wintermao/CycloneIV_DDR2/(list of files, cad)

Other CAD files:
ddr_layout_V5/test_dac2904_jit.stp
ddr_layout_V5/test_dac2904_jit_auto_stripped.stp
ddr_layout_V5/spi_da.stp
ddr_layout_V5/spi_da_auto_stripped.stp
ddr_layout_V5/spi_test.stp
ddr_layout_V5/spi_test_auto_stripped.stp
