wintermao/CycloneIV_DDR2/ddr_layout_V5/software/timestamp/test result.txt

//base_addr=0x4000000
system freq= 54000000 Hz
test data size=0x100000
byte mode: t0=232 t1=161813278 dt=161813046 time=2.996538s
word mode : t0=161920835 t1=243030699 dt=81109864 time=1.502035s
dword mode : t0=243136543 t1=283690981 dt=40554438 time=0.751008s
ddword mode : t0=283799846 t1=306557779 dt=22757933 time=0.421443s

//base_addr=0x000000
system freq= 54000000 Hz
test data size=0x100000
byte mode: t0=246 t1=161667552 dt=161667306 time=2.993839s
word mode : t0=161772758 t1=242826644 dt=81053886 time=1.500998s
dword mode : t0=242932235 t1=283452481 dt=40520246 time=0.750375s
ddword mode : t0=283560182 t1=306285879 dt=22725697 time=0.420846s
