wintermao/CycloneIV_DDR2/ddr_layout_V5/ip/triangle_demodu/hdl/triangle_define.v

`define ADDR_AMP_MAX				4'h0
`define ADDR_AMP_MIN				4'h1
`define ADDR_FREQ_DIV				4'h2
`define ADDR_POINT					4'h3
`define ADDR_SAMPLE1_START	4'h4
`define ADDR_SAMPLE2_START	4'h5
`define ADDR_SAMPLE1_NUM		4'h6
`define ADDR_SAMPLE2_NUM		4'h7
