wintermao/CycloneIV_DDR2/ddr_layout_V5/software/dma_epcs_to_dac/clk_device.h

/*
 * clk_device.h
 *
 *  Created on: 2018-4-14
 *      Author: mmh
 */

#ifndef CLK_DEVICE_H_
#define CLK_DEVICE_H_
#define AD1	0
#define AD2	1
#define DAC1 2
#define DAC2 3
#define DAC3 4
#define DAC4 5
#define LIGHT 6

#endif /* CLK_DEVICE_H_ */
