wintermao/CycloneIV_DDR2/ddr_layout_V5/ip/i2c_opencores/HAL/inc/i2c_opencores.h

#ifndef __I2C_OPENCORES_H__
#define __I2C_OPENCORES_H__


#include "alt_types.h"

#ifdef __cplusplus
extern "C"
{
#endif /* __cplusplus */




void I2C_init(alt_u32 base,alt_u32 clk,alt_u32 speed);
int I2C_start(alt_u32 base, alt_u32 add, alt_u32 read);
alt_u32 I2C_read(alt_u32 base,alt_u32 last);
alt_u32 I2C_write(alt_u32 base,alt_u8 data, alt_u32 last);
#define I2C_OK (0)
#define I2C_ACK (0)
#define I2C_NOACK (1)
#define I2C_ABITRATION_LOST (2)

#define I2C_OPENCORES_INSTANCE(name, dev) extern int alt_no_storage
#define I2C_OPENCORES_INIT(name, dev) while (0)

#ifdef __cplusplus
}
#endif /* __cplusplus */

#endif /* __I2C_OPENCORES_H__ */
