wintermao/CycloneIV_DDR2/ddr_layout_V5/ip/ad9245/hdl/ad9245.v

module ad9245					
(
	//ad9245 interface
	input  wire [13:0] ad_data,		//ad sample data
	
	//AVALON interface
	input  wire clk,							//AVALON clock
	input  wire reset_n,					//AVALON reset_n
	input  wire chipselect,				//AVALON chipselect
	input  wire read,							//AVALON read
	output reg [31:0] readdata		//AVALON read data
);

	always @(posedge clk or negedge reset_n)
	begin
		if (!reset_n)
		begin
			//system init
		end
		else
		begin
			if(chipselect && read)		//AVALON read 
			begin
				readdata <= {18'h0,ad_data};
			end
		end
	end

endmodule
