wintermao/CycloneIV_DDR2/ddr_layout_V5/ip/wave_gen/hdl/Cordic_Test.v

module Cordic_Test
(
    CLK_50M,RST_N,
    Phase,
    Sin,Cos,Error
);

input                       CLK_50M;
input                       RST_N;
input       [31:0]          Phase;
output      [31:0]          Sin;
output      [31:0]          Cos;
output      [31:0]          Error;

`define rot0  32'd2949120       //45¶È*2^16
`define rot1  32'd1740992       //26.5651¶È*2^16
`define rot2  32'd919872        //14.0362¶È*2^16
`define rot3  32'd466944        //7.1250¶È*2^16
`define rot4  32'd234368        //3.5763¶È*2^16
`define rot5  32'd117312        //1.7899¶È*2^16
`define rot6  32'd58688         //0.8952¶È*2^16
`define rot7  32'd29312         //0.4476¶È*2^16
`define rot8  32'd14656         //0.2238¶È*2^16
`define rot9  32'd7360          //0.1119¶È*2^16
`define rot10 32'd3648          //0.0560¶È*2^16
`define rot11 32'd1856          //0.0280¶È*2^16
`define rot12 32'd896           //0.0140¶È*2^16
`define rot13 32'd448           //0.0070¶È*2^16
`define rot14 32'd256           //0.0035¶È*2^16
`define rot15 32'd128           //0.0018¶È*2^16

parameter Pipeline = 16;
parameter K = 32'h09b74;    //K=0.607253*2^16,32'h09b74,

reg signed  [31:0]      Sin;
reg signed  [31:0]      Cos;
reg signed  [31:0]      Error;
reg signed  [31:0]      x0=0,y0=0,z0=0;
reg signed  [31:0]      x1=0,y1=0,z1=0;
reg signed  [31:0]      x2=0,y2=0,z2=0;
reg signed  [31:0]      x3=0,y3=0,z3=0;
reg signed  [31:0]      x4=0,y4=0,z4=0;
reg signed  [31:0]      x5=0,y5=0,z5=0;
reg signed  [31:0]      x6=0,y6=0,z6=0;
reg signed  [31:0]      x7=0,y7=0,z7=0;
reg signed  [31:0]      x8=0,y8=0,z8=0;
reg signed  [31:0]      x9=0,y9=0,z9=0;
reg signed  [31:0]      x10=0,y10=0,z10=0;
reg signed  [31:0]      x11=0,y11=0,z11=0;
reg signed  [31:0]      x12=0,y12=0,z12=0;
reg signed  [31:0]      x13=0,y13=0,z13=0;
reg signed  [31:0]      x14=0,y14=0,z14=0;
reg signed  [31:0]      x15=0,y15=0,z15=0;
reg signed  [31:0]      x16=0,y16=0,z16=0;
reg         [ 1:0]      Quadrant [Pipeline:0];

always @ (posedge CLK_50M or negedge RST_N)
begin
    if(!RST_N)
    begin
        x0 <= 1'b0;                         
        y0 <= 1'b0;
        z0 <= 1'b0;
    end
    else
    begin
        x0 <= K;
        y0 <= 32'd0;
        z0 <= Phase[24:0];
    end
end

always @ (posedge CLK_50M or negedge RST_N)
begin
    if(!RST_N)
    begin
        x1 <= 1'b0;                         
        y1 <= 1'b0;
        z1 <= 1'b0;
    end
    else if(z0[31])
    begin
      x1 <= x0 + y0;
      y1 <= y0 - x0;
      z1 <= z0 + `rot0;
    end
    else
    begin
      x1 <= x0 - y0;
      y1 <= y0 + x0;
      z1 <= z0 - `rot0;
    end
end

always @ (posedge CLK_50M or negedge RST_N)
begin
    if(!RST_N)
    begin
        x2 <= 1'b0;                         
        y2 <= 1'b0;
        z2 <= 1'b0;
    end
    else if(z1[31])
   begin
        x2 <= x1 + (y1 >>> 1);
        y2 <= y1 - (x1 >>> 1);
        z2 <= z1 + `rot1;
   end
   else
   begin
       x2 <= x1 - (y1 >>> 1);
       y2 <= y1 + (x1 >>> 1);
       z2 <= z1 - `rot1;
   end
end

always @ (posedge CLK_50M or negedge RST_N)
begin
    if(!RST_N)
    begin
        x3 <= 1'b0;                         
        y3 <= 1'b0;
        z3 <= 1'b0;
    end
    else if(z2[31])
   begin
       x3 <= x2 + (y2 >>> 2);
       y3 <= y2 - (x2 >>> 2);
       z3 <= z2 + `rot2;
   end
   else
   begin
       x3 <= x2 - (y2 >>> 2);
       y3 <= y2 + (x2 >>> 2);
       z3 <= z2 - `rot2;
   end
end

always @ (posedge CLK_50M or negedge RST_N)
begin
    if(!RST_N)
    begin
        x4 <= 1'b0;                         
        y4 <= 1'b0;
        z4 <= 1'b0;
    end
    else if(z3[31])
   begin
       x4 <= x3 + (y3 >>> 3);
       y4 <= y3 - (x3 >>> 3);
       z4 <= z3 + `rot3;
   end
   else
   begin
       x4 <= x3 - (y3 >>> 3);
       y4 <= y3 + (x3 >>> 3);
       z4 <= z3 - `rot3;
   end
end

always @ (posedge CLK_50M or negedge RST_N)
begin
    if(!RST_N)
    begin
        x5 <= 1'b0;                         
        y5 <= 1'b0;
        z5 <= 1'b0;
    end
    else if(z4[31])
   begin
       x5 <= x4 + (y4 >>> 4);
       y5 <= y4 - (x4 >>> 4);
       z5 <= z4 + `rot4;
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
        z15 <= 1'b0;
    end
    else if(z14[31])
   begin
       x15 <= x14 + (y14 >>> 14);
       y15 <= y14 - (x14 >>> 14);
       z15 <= z14 + `rot14;
   end
   else
   begin
       x15 <= x14 - (y14 >>> 14);
       y15 <= y14 + (x14 >>> 14);
       z15 <= z14 - `rot14;
   end
end

always @ (posedge CLK_50M or negedge RST_N)
begin
    if(!RST_N)
    begin
        x16 <= 1'b0;                        
        y16 <= 1'b0;
        z16 <= 1'b0;
    end
    else if(z15[31])
   begin
       x16 <= x15 + (y15 >>> 15);
       y16 <= y15 - (x15 >>> 15);
       z16 <= z15 + `rot15;
   end
   else
   begin
       x16 <= x15 - (y15 >>> 15);
       y16 <= y15 + (x15 >>> 15);
       z16 <= z15 - `rot15;
   end
end

always @ (posedge CLK_50M or negedge RST_N)
begin
    if(!RST_N)
    begin
        Quadrant[0] <= 1'b0;
        Quadrant[1] <= 1'b0;
        Quadrant[2] <= 1'b0;
        Quadrant[3] <= 1'b0;
        Quadrant[4] <= 1'b0;
        Quadrant[5] <= 1'b0;
        Quadrant[6] <= 1'b0;
        Quadrant[7] <= 1'b0;
        Quadrant[8] <= 1'b0;
        Quadrant[9] <= 1'b0;
        Quadrant[10] <= 1'b0;
        Quadrant[11] <= 1'b0;
        Quadrant[12] <= 1'b0;
        Quadrant[13] <= 1'b0;
        Quadrant[14] <= 1'b0;
        Quadrant[15] <= 1'b0;
        Quadrant[16] <= 1'b0;
    end
    else
    begin
        Quadrant[0] <= Phase[26:25];
        Quadrant[1] <= Quadrant[0];
        Quadrant[2] <= Quadrant[1];
        Quadrant[3] <= Quadrant[2];
        Quadrant[4] <= Quadrant[3];
        Quadrant[5] <= Quadrant[4];
        Quadrant[6] <= Quadrant[5];
        Quadrant[7] <= Quadrant[6];
        Quadrant[8] <= Quadrant[7];
        Quadrant[9] <= Quadrant[8];
        Quadrant[10] <= Quadrant[9];
        Quadrant[11] <= Quadrant[10];
        Quadrant[12] <= Quadrant[11];
        Quadrant[13] <= Quadrant[12];
        Quadrant[14] <= Quadrant[13];
        Quadrant[15] <= Quadrant[14];
        Quadrant[16] <= Quadrant[15];
    end
end

always @ (posedge CLK_50M or negedge RST_N)
begin
    if(!RST_N)
    begin
        Cos <= 1'b0;
        Sin <= 1'b0;
        Error <= 1'b0;
    end
    else
    begin
        Error <= z16;
        case(Quadrant[16])
            2'b00: //if the Phase is in first Quadrant,the Sin(X)=Sin(A),Cos(X)=Cos(A)
                begin
                    Cos <= x16;
                    Sin <= y16;
                end
            2'b01: //if the Phase is in second Quadrant,the Sin(X)=Sin(A+90)=CosA,Cos(X)=Cos(A+90)=-SinA
                begin
                    Cos <= ~(y16) + 1'b1;//-Sin
                    Sin <= x16;//Cos
                end
            2'b10: //if the Phase is in third Quadrant,the Sin(X)=Sin(A+180)=-SinA,Cos(X)=Cos(A+180)=-CosA
                begin
                    Cos <= ~(x16) + 1'b1;//-Cos
                    Sin <= ~(y16) + 1'b1;//-Sin
                end
            2'b11: //if the Phase is in forth Quadrant,the Sin(X)=Sin(A+270)=-CosA,Cos(X)=Cos(A+270)=SinA
                begin
                    Cos <= y16;//Sin
                    Sin <= ~(x16) + 1'b1;//-Cos
                end
        endcase
    end
end

endmodule
