wintermao/CycloneIV_DDR2/ddr_layout_V5/software/spi_test/ad5142_regs.h

/*
 * ad5142_regs.h
 *
 *  Created on: 2018-2-3
 *      Author: mmh
 */

#ifndef __AD5142_REG_H__
#define __AD5142_REG_H__

#define AD5142_COMMAND_SERIAL_TO_RDAC	0x10
#define AD5142_COMMAND_SERIAL_TO_INPUT	0x20
#define AD5142_COMMAND_READ				0x30
#define AD5142_COMMAND_INPUT_TO_RDAC	0x60
#define AD5142_COMMAND_RDAC_TO_EEPROM	0x70
#define AD5142_COMMAND_EEPROM_TO_RDAC	0x70
#define AD5142_COMMAND_SERIAL_TO_EEPROM	0x80
#define AD5142_COMMAND_RESET	0xB0
#define AD5142_COMMAND_SERIAL_TO_CONTROL	0xD0

#define AD6152_DIRECTION_EEPROM_TO_RDAC	0
#define AD6152_DIRECTION_RDAC_TO_EEPROM	1

#define AD5142_REGISTER_INPUT	0
#define AD5142_REGISTER_EEPROM	1
#define AD5142_REGISTER_CONTROL	2
#define AD5142_REGISTER_RDAC	3

#define AD5142_CONTROL_RDAC_MSK	0x01
#define AD5142_CONTROL_EEPROM_MSK	0x02
#define AD5142_CONTROL_MODE_MSK	0x04

#define AD5142_CONTROL_RDAC_PROTECT	0x00
#define AD5142_CONTROL_RDAC_NORMAL	0x01
#define AD5142_CONTROL_EEPROM_PROTECT	0x00
#define AD5142_CONTROL_EEPROM_NORMAL	0x10
#define AD5142_CONTROL_MODE_POTETIOMETER	0x00
#define AD5142_CONTROL_MODE_LINEARGAIN	0x20

#define AD5142_RDAC1_ADDRESS	0
#define AD5142_RDAC2_ADDRESS	1
#define AD5142_RDAC_ADDRESS_MSK	0X01

#endif /* __AD5142_REG_H__ */
