wintermao/CycloneIV_DDR2/ddr_layout_V5/software/spi_test/ad5781_regs.h

/*
 * ad5781_regs.h
 *
 *  Created on: 2018-2-25
 *      Author: mmh
 */

#ifndef __AD5781_REG_H__
#define __AD5781_REG_H__

#define AD5781_REGISTER_INPUT	0
#define AD5781_REGISTER_DAC	0X100000
#define AD5781_REGISTER_CONTROL	0X200000
#define AD5781_REGISTER_CLEAR	0X300000
#define AD5781_REGISTER_SOFT	0X400000

#define AD5781_CONTROL_RBUF_MSK	0x2
#define AD5781_CONTROL_OPGND_MSK	0x04
#define AD5781_CONTROL_DACTRI_MSK	0x08
#define AD5781_CONTROL_BIN_2SC_MSK	0x10
#define AD5781_CONTROLSDODIS_MSK	0x20
#define AD5781_CONTROL_LINCOMP_MSK	0x3C0

#define AD5781_SOFT_LDAC_MSK	0x01
#define AD5781_SOFT_CLR_MSK	0x02
#define AD5781_SOFT_RESET_MSK	0x04

#endif /* __AD5781_REG_H__ */
