wintermao/CycloneIV_DDR2/(commit log)

2018-01-19 这些文件可以由qsys编译生成，无需上传
2018-01-19 删除未删除的文件
2018-01-21 修改ddr时钟桥的m0 clk为ddr sysclk
2018-01-21 software新增led_test工程
2018-01-24 新增Boad_Diagnostics软件工程
2018-01-24 更新编译错误
2018-01-24 更改闪灯顺序
2018-01-27 新增spi_test软件工程
2018-01-28 增加头文件，重新命名
2018-01-28 重命名为spi_test.c,删除
2018-01-28 新增spi调试用signalTap
    [stp3.stp]
2018-01-28 修改程序结构
2018-01-30 专用于spi测试
    [spi_test.stp]
2018-01-31 1新增led_flash模块，实现下载sof后自动闪灯，以确认程序在运行，引脚锁定在led【3】
2018-01-31 增加led_flash,标识程序运行。增加spi_sdo上拉，stp可检测到数据变化，标记
2018-02-02 新增TestUart工程，用于测试jtagUart与Uart交叉发送接收数据
2018-02-03 新增ad5142驱动 修改spi_test为8位方式，操作ad5142，结果不正确，原因待查
2018-02-05 fpga工程 1 增加timestamp，用于计量运行时间； 2 增加dma 3 修改ddr2时钟桥地址范围为0x4000000 4 修改pll输出，取消c3，用c1替换 5 修改spi core为8位方式 nios工程 1 增加timestamp应用，测试ddr2 8、16、32、64位传输时间 2 增加epcs应用，测试读写epcs flash，暂未调通 3 增加dma应用，测试ddr到dd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
    [spi_test.stp]
2018-02-07 测试删除
    [spi_test.stp, spi_test_auto_stripped.stp]
2018-02-07 Revert "测试删除"
    This reverts commit 863aa69468d0393559d66c6956d9a0049749189d.
    [spi_test.stp, spi_test_auto_stripped.stp]
2018-02-11 fpga工程 1 qsys引出epcs引脚，并在pin planner中锁定epcs四个引脚 2 修改dual-pupose pins功能引脚为Use as regular I/O 3 修改AS Configuration device I/O voltage:3.3v 4 取消Generate compressed bitstreams 5 DP开关reset脚连接LED[3],用GPIO产生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
    [spi_test.stp, spi_test_auto_stripped.stp]
2018-02-24 1 修改AS配置芯片为EPCS128 2 修改SPI的时序为下降沿、第一个时钟采样 3 修改epcs_test.c中open device中参数为宏引用 4 修改ad5142.c中读命令为写16bit命令后拉高片选，再读16bit数据，调试验证通过
2018-02-25 add documents
    [ADI数字电位器参数搜索.xlsx, ADI高精度运放参数搜索.xlsx, ADI高速AD参数搜索.xlsx, BOM_12_25.xlsx, EP4C115F29.csv, EP4C115F29_Pin.xlsx, EP4C115F29_Pin_10_12.xlsx, EP4C115F29_Pin_10_14.xlsx]
2018-02-25 1 新增ad5781驱动 2 修改ad5142驱动中dev结构体命名，与芯片名保持一致 3 修改spi_test工程，增加ad5781测试，去除多余代码 4 nios中增加spi_ad5781 5 增加DP_SPI_SDO引脚上拉约束，以去掉外部上拉电阻
2018-03-02 1 新增ipcore路径，并增加为qsys的ip搜索路径 2 新增ad9245 core，驱动部分未完成系统关联、调试 3 新增ad5781逻辑分析文件 4 系统增加nios_clk时钟桥，引出nios系统时钟，用于测试 5 系统增加2个ad9245模块，总线挂慢速设备，采样使用同样适用慢速时钟54M 6 修改27M晶振输入网络名，有sys_clk改为osc_clk
    [spi_da.stp, spi_da_auto_stripped.stp]
2018-03-04 1 去掉ad9245时钟输入、输出，调通软件驱动 2 新增dac2904模块及驱动，驱动编译通过 3 新增clk_gen模块及驱动，驱动编译通过 4 有clk_gen产生ad、da的采样使用，并产生闪灯脉冲 5 外部模块路径由ipcore改为ip，如此系统可自动搜索 6 qsys增加4个dac2904，2个ad9245
2018-03-04 增加《nios工程路径更改编译方法》
2018-03-05 1 修正ad5781_read_control（）写第二、第三字节错误问题 2 修改头文件文件名宏定义格式，与组件驱动保持一致 3 修正spi_test工程编译警告 4 ad5781_init（）增加ad5781_write_control（）调用，保证5781进入正常工作状态
    [ad5142_regs.h, ad5142_spi.h, ad5781_regs.h, ad5781_spi.c, ad5781_spi.h, spi_test.c, spi_test.h]
2018-03-05 溢出led_flash模块，由clk_gen的light_clk输出，默认1次/秒闪烁
2018-03-06 1 spec增加nios embedded ip编程文档 2 ip增加spi_master、old两个ip核，待完成
2018-03-06 完善spi_master,补充状态寄存器逻辑、控制寄存器逻辑，终端引脚逻辑有问题，片选保持为低逻辑未实现
2018-03-07 1 新增i2c_opencores核 2 新增oc_i2c_master核 3 新增oc_spi核 4 spi_test工程增加interrupt演示代码
2018-03-08 1 更新oc_i2c_master核，在ep2c8上调试通过 2 新增test_eeprom工程，用于测试eeprom读写，在ep2c8上调试通过 3 删除oc_i2c_master核不必要的文件，尤其oc_i2c_master_setup.tcl会导致nios的模块文件内容为空
2018-03-08 系统增加i2c模块，重新编译通过
2018-03-09 解决spi_master无法通过组件编辑器导入问题： 1 status有在多个always块赋值 2 slave_chipselect书写错误 3 reg变量使用了assign赋值
    [spi_master.v]
2018-03-10 spi_master ip核编译通过，未调试，中断标志暂屏蔽
2018-03-20 新增AD9266 AN-877 Application note
2018-03-28 修改 gen_clk,增加 testbench,未完成调试
2018-04-08 新增test_ad工程，dac输出给ad，4个按键分别对应+10，+100，-10，-100
2018-04-14 修改clk_gen模块为支持16路时钟输出，最小2分频的自然数分频，同步更新cl_gen_tb，用于仿真
2018-04-14 更新clk_gen驱动
2018-04-14 更新clk_gen组件描述，版本2.0
2018-04-14 纠正驱动命名错误
2018-04-14 修改test_ad相关clk_gen部分的调用接口，新增各时钟接口与ad、dac的对应关系
2018-04-14 新增SPI_Out_EN模块源文件，用于ad9266接口
2018-04-14 修改clk_gen后，更新系统工程
2018-04-16 dac2904新模块，增加时钟输入，用于在dma传输时产生waitrequest信号
2018-04-17 修改dma传输长度为25位 新增dma_ddr_to_dac工程，实现代码传输，从ddr到dac1，调试通过，传输时间记录在dma transmit time.xlsx中
    [dma transmit time.xlsx]
2018-04-19 删除bsp工程中不必要的文件，这些文件都可以动态生成
2018-04-19 1 更新dac2904 ip核，增加waitrequest信号，用于解决慢速设备的速率匹配问题 2 更新系统工程，由于dac2094新模块增加了采样时钟输入引脚 3 更新dma_ddr_to_dac工程，用于测试传输速率 4 更新dma测试结果
    [dma transmit time.xlsx]
2018-04-19 删除doc资料目录，在github上新建库保存，避免下载代码工程时额外下载文档目录的内容
    [ADI数字电位器参数搜索.xlsx, ADI高精度运放参数搜索.xlsx, ADI高速AD参数搜索.xlsx, BOM_12_25.xlsx, EP4C115F29.csv, EP4C115F29_Pin.xlsx, EP4C115F29_Pin_10_12.xlsx, EP4C115F29_Pin_10_14.xlsx]
2018-04-20 更新dma测试结果，初步结论如下： 1 增加dma fifo对速度无作用 2 提升dma控制器时钟对速度无作用 3 加大ddr burst对速度无作用 4 改在onchipram运行程序对速度无作用 怀疑接口模块有其他问题限制了传输速度，否则ddr的传输速度堪忧
    [dma transmit time.xlsx]
2018-04-23 1 更新dac2904模块，增加dcfifo，32位写16位读，用于dma32位传入数据，再14位输出给DAC，256点正弦波频率可达70k以上，波形上有竖线需后续分析原因 2 dac2904模块增加到系统中后，在quartus编译时文件大小为0，需直接拷贝覆盖，原因待分析 3 更新dma_ddr_to_dac测试程序
2018-04-24 1 dma_ddr_to_dac生成正弦波验证结果如下： 1） divide=8,size_byte=0x20000,step=pi*2/size_byte*2*256----波形52k， 峰值处有闪烁干扰，signaltap捕捉不到干扰，怀疑为波形计算结果引起的偏差 2） divide=8,size_byte=0x20000,step=pi*2/size_byte*2*16 ----波形3.3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
2018-04-28 1 新增wave_gen模块， 1）用硬逻辑实现锯齿波、三角波、正弦波，频率可调，周期采样点数可调，三角波、锯齿波幅度可调， 2）正弦波幅度暂不能调整，后续考虑优化 3）附带模块测试文件和cordic测试文件 2 模块增加到qsys，并在quartus系统编译通过，未在nios调试 3 软件驱动仅写了reg驱动，其他未完成 4 补充dac2904的测试文件
2018-04-30 更新计数方法缺陷
2018-04-30 1 增加正弦波赋值调整 2 增加直接写dac，用于调试用所需的特定输出设置 3 更新寄存器驱动文件 4 更新模块描述文件
2018-04-30 增加对分频值为1的支持
2018-04-30 修改clk_out类型
2018-04-30 新增demodulation模块，编译通过，未调试。testbench未完成。
2018-05-02 增加wave_gen软件驱动，调试通过
2018-05-02 增加wave输出测试软件，循环输出四种波形，调试通过
2018-05-02 加浮点到整型的强制类型转换
2018-05-02 1 新增demodulation驱动，编译通过 2 新增demodu_test软件工程，编译通过 3 更新demodulation模块，输出为14位无符号数 4 更新qsys及系统工程，待现场与硬件联调
2018-05-03 现场调试版本： 1 dac1产生1hz锯齿波，dac3、dac4产生60、61khz三角波，其中61khz利用减少波形采样点方式实现 2 更新qsys、系统工程 3 更新demodu_test工程文件
2018-05-03 新增triangle_demodu模块 1 整合调制、解调两个模块，自带时钟输出驱动ad、DAC 2 新增triangle_demodu_test软件工程，用于测试以上模块 3 更新qsys、系统工程，编译通过未调试
2018-05-20 文件转换，用于将正弦波、三角波的文本文件转换为bin文件，采用hosts功能，以debug运行方式存储转换后的文件到pc机，由于运行速度较慢，未完成全部调试
2018-05-20 将波形文件由bin->flash->hex->jic,通过jtag写入到epcs 增加wave-bin2flash.sh,将bin转为flash格式 增加wave-flash2hex.sh,将flash转为hex格式 用编程文件转换工具将以上hex转为jic
2018-05-20 1 解决分频值为2时无输出问题 2 修改时钟输出为翻转方式，计数的中值时减一 3 增加计数值为1时跟随输入时钟 4 更新仿真文件，测试clk_pre为1
    [clk_gen.v, clk_gen_tb.v]
2018-05-21 解决分频值为2时，时钟无输出问题
2018-05-23 增加read_epcs_per_block工程，用于读取epcs每一个块的前32字节，以检查是否与写入数据一致
2018-05-23 更改写入epcs的block位置，原写入最后一个block，由于最后4个block已用于存储波形数据，需要保留
2018-05-23 用generate语法的for循环实现assign对多个输出的赋值，目的是解决分频值为1时的时钟输出
2018-05-23 新增dma_epcs_to_dac工程，实现从epcs读取波形数据，再通过dma由dac2904输出 更新qsys及系统工程，将DA1由原波形输出移动到dac2904输出
2018-05-23 cpu设为高性能，使能指令、数据的突发支持
2018-05-24 增加dac2904的signaltap文件
    [test_dac2904_jit.stp, test_dac2904_jit_auto_stripped.stp]
