wintermao/CycloneIV_DDR2/(notices)

Notices in the files:
ddr_layout_V5/ip/i2c_opencores/hdl/i2c_master_byte_ctrl.v:
Copyright (C) 2001 Richard Herveille
ddr_layout_V5/ip/oc_spi/hdl/spi_shift.v:
Copyright (C) 2002 Authors
Public License as published by the Free Software Foundation;
Public License along with this source; if not, download it
from http://www.opencores.org/lgpl.shtml
